UCHIC/CIWS-Loggers/Current_Designs/README.md

This folder contains the design files for the dataloggers currently in use. Each of the folders pertains to a particular datalogger, and contains the hardware and firmware/software design files, along with relevant documentation.
