UCHIC/CIWS-Loggers/Current_Designs/Residential_Datalogger/Tools/README.md

This folder contains software tools to aid in setup and operation of the Residential Datalogger.<br/>
The folder RawDataCollector contains a program that the Residential Datalogger can use to store raw data from the magnetometer. This is useful for anyone needing to characterize the magnetic signal coming from a register.<br/>
The folder RawDataProcessor contains a python module that takes the raw data and processes it to verify if certain settings will work.
