UCHIC/CIWS-Loggers/Current_Designs/Campus_Datalogger/Software/README.md

There are two scripts here for two different dataloggers:

meterlog.py: For the datalogger equipped to measure one water line

Integratable_multimeter_logger_with_temperature_and_chunkingTest.py: For the datalogger equipped to measure three water lines and temperature
