UCHIC/CIWS-Loggers/doc/requiredcomponents.md

### Required components to build the AggieWater Smart Water Meter
1 - Raspberry Pi 3 - Model B - ARMv8 with 1G RAM with Raspbian operating system in a 8GB SD card  
1 - USB WiFi (802.11b/g/n) Module with Antenna for Raspberry Pi  
1 - MCP3008 - 8-Channel 10-Bit ADC With SPI Interface  
1 - Perma-Proto HAT for Pi  with GPIO header  
1 - AH3761 High sensitivity hall effect lacth  
1 - Mini DC/DC Step-Down (Buck) Converter - 5V @ 1A output - TSR12450   
7 - 10k resistors  
2 - 1k resistors  
1 - red led  
1 - green led  
1 - 12 pin header  
4 - header jumpers  
4 - pair of screw in terminal blocks  
1 - Deep cycle Battery with at least 10AH 12v  
1 - Pelycan box with capacity to hold the datalogger and battery  

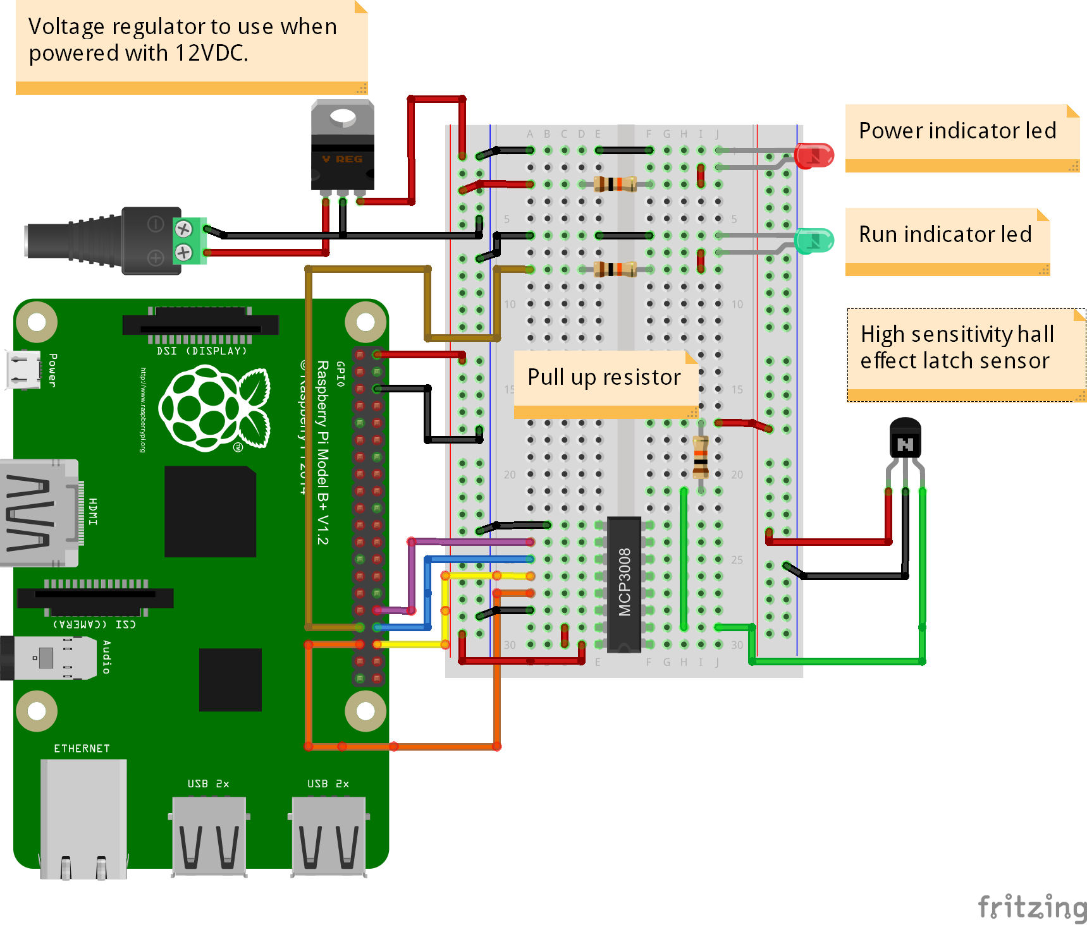
[picture p2: doc/images/MCP3008__to_RPI.png]

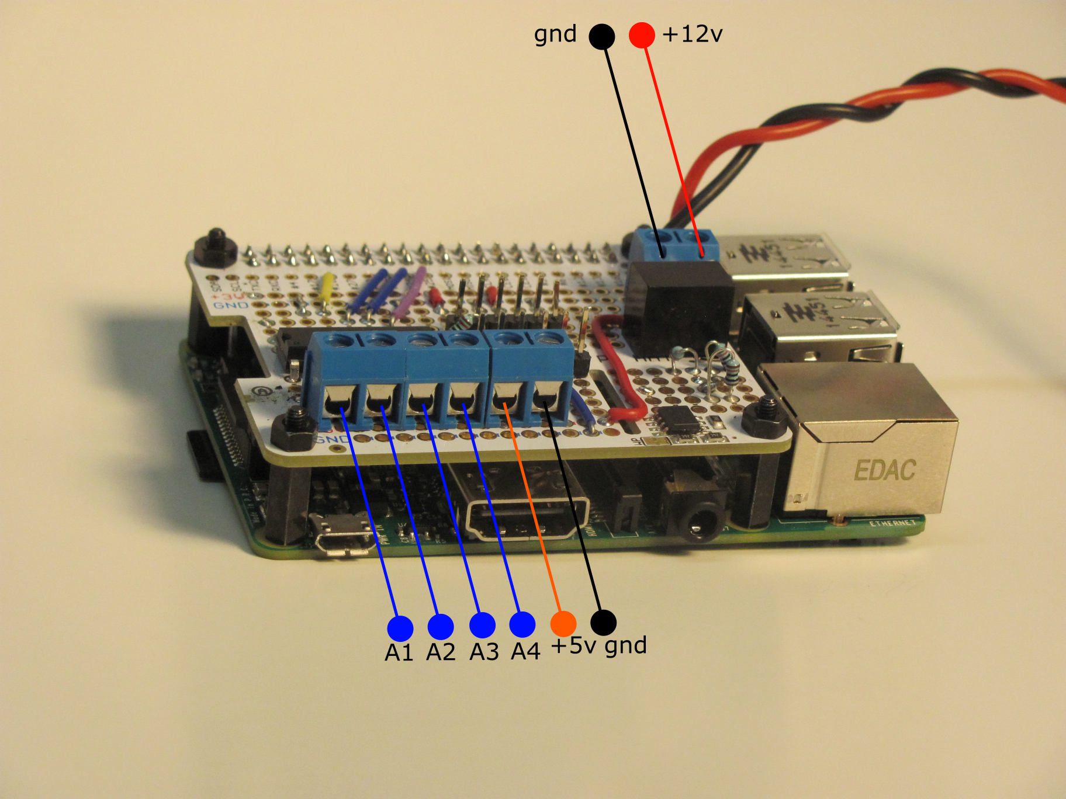
[picture p3: doc/images/AGGIEWATER_PORTS.png]
