UCHIC/CIWS-Loggers/Current_Designs/Residential_Datalogger/Hardware/README.md

This folder contains documents relating to hardware design and construction. The circuits seen in Residential_Design.pdf are added to the prototyping area of the Adafruit Datalogging Shield (Product #1141). Modifications to the shield are detailed in Datalogger_Shield_Modification_Instructions.txt. The layout is demonstrated in Residential_Layout.png, and the final product is shown in Residential_Datalogger.jpg.
