UCHIC/CIWS-Loggers/Current_Designs/Residential_Datalogger/Tools/RawDataProcessor/X_Data.csv

Raw_signal | Signal_with_offset_removed | Schmitt_trigger_output | Pulses_counted
-10.000000 | -10.000000 | 0.000000 | 0.000000
-10.000000 | -9.500000 | 0.000000 | 0.000000
-10.000000 | -9.025000 | 0.000000 | 0.000000
-10.000000 | -8.573750 | 0.000000 | 0.000000
-10.000000 | -8.145061 | 0.000000 | 0.000000
-10.000000 | -7.737808 | 0.000000 | 0.000000
-10.000000 | -7.350918 | 0.000000 | 0.000000
-10.000000 | -6.983372 | 0.000000 | 0.000000
-10.000000 | -6.634203 | 0.000000 | 0.000000
-10.000000 | -6.302492 | 0.000000 | 0.000000
-10.000000 | -5.987368 | 0.000000 | 0.000000
-10.000000 | -5.688000 | 0.000000 | 0.000000
-10.000000 | -5.403600 | 0.000000 | 0.000000
-10.000000 | -5.133419 | 0.000000 | 0.000000
-10.000000 | -4.876748 | 0.000000 | 0.000000
-10.000000 | -4.632911 | 0.000000 | 0.000000
-10.000000 | -4.401265 | 0.000000 | 0.000000
-10.000000 | -4.181202 | 0.000000 | 0.000000
-10.000000 | -3.972141 | 0.000000 | 0.000000
-10.000000 | -3.773534 | 0.000000 | 0.000000
-10.000000 | -3.584857 | 0.000000 | 0.000000
-10.000000 | -3.405614 | 0.000000 | 0.000000
-10.000000 | -3.235333 | 0.000000 | 0.000000
-10.000000 | -3.073566 | 0.000000 | 0.000000
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
