UCHIC/CIWS-Loggers/Current_Designs/Residential_Datalogger/Tools/RawDataProcessor/RAW_DATA.CSV

X_Axis | Y_Axis | Z_Axis
-10 | 18 | -2
-10 | 18 | -2
-10 | 18 | -2
-10 | 18 | -2
-10 | 18 | -2
-10 | 18 | -2
-10 | 18 | -2
-10 | 18 | -2
-10 | 18 | -2
-10 | 18 | -2
-10 | 18 | -2
-10 | 18 | -2
-10 | 18 | -2
-10 | 18 | -2
-10 | 18 | -2
-10 | 18 | -2
-10 | 18 | -2
-10 | 18 | -2
-10 | 18 | -2
-10 | 18 | -2
-10 | 18 | -2
-10 | 18 | -2
-10 | 18 | -2
-10 | 18 | -2
-10 | 18 | -2
-10 | 18 | -2
-10 | 18 | -2
-10 | 18 | -2
-10 | 18 | -2
-10 | 18 | -2
-10 | 18 | -2
-10 | 18 | -2
-10 | 18 | -2
-10 | 18 | -2
-10 | 18 | -2
-10 | 18 | -2
-10 | 18 | -2
-10 | 18 | -2
-10 | 18 | -2
-10 | 18 | -2
-10 | 18 | -2
-10 | 18 | -2
-10 | 18 | -2
-10 | 18 | -2
-10 | 18 | -2
-10 | 18 | -2
-10 | 18 | -2
-10 | 18 | -1
-10 | 18 | -2
-10 | 18 | -2
-10 | 18 | -2
-10 | 18 | -2
-10 | 18 | -2
-10 | 18 | -2
-10 | 18 | -2
-10 | 18 | -2
-10 | 18 | -2
-10 | 18 | -2
-10 | 18 | -2
-10 | 18 | -1
-10 | 18 | -2
-10 | 18 | -2
-10 | 18 | -2
-10 | 18 | -2
-10 | 18 | -2
-10 | 18 | -2
-10 | 18 | -2
-10 | 18 | -2
-10 | 18 | -2
-10 | 18 | -2
-10 | 18 | -2
-10 | 18 | -2
-10 | 18 | -2
-10 | 18 | -2
-10 | 18 | -2
-10 | 18 | -2
-10 | 18 | -2
-10 | 18 | -1
-10 | 18 | -1
-10 | 18 | -2
-10 | 18 | -2
-10 | 18 | -2
-10 | 18 | -2
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
