UCHIC/CIWS-Loggers/Previous_Designs/README.md

This folder contains the design files for previous versions of the datalogger prototypes. They are no longer in use, and are kept here to show the progression of the project.
