UCHIC/CIWS-Loggers/Previous_Designs/Hybrid_Prototype/README.md

This is the firmware for the original Computational Datalogger, nicknamed the "Hybrid Prototype" because it involved two main devices, an AVR Microcontroller and a Raspberry Pi.
