UCHIC/CIWS-Loggers/Current_Designs/Campus_Datalogger/Hardware/4-20mA_Pi_Hat_Design.png

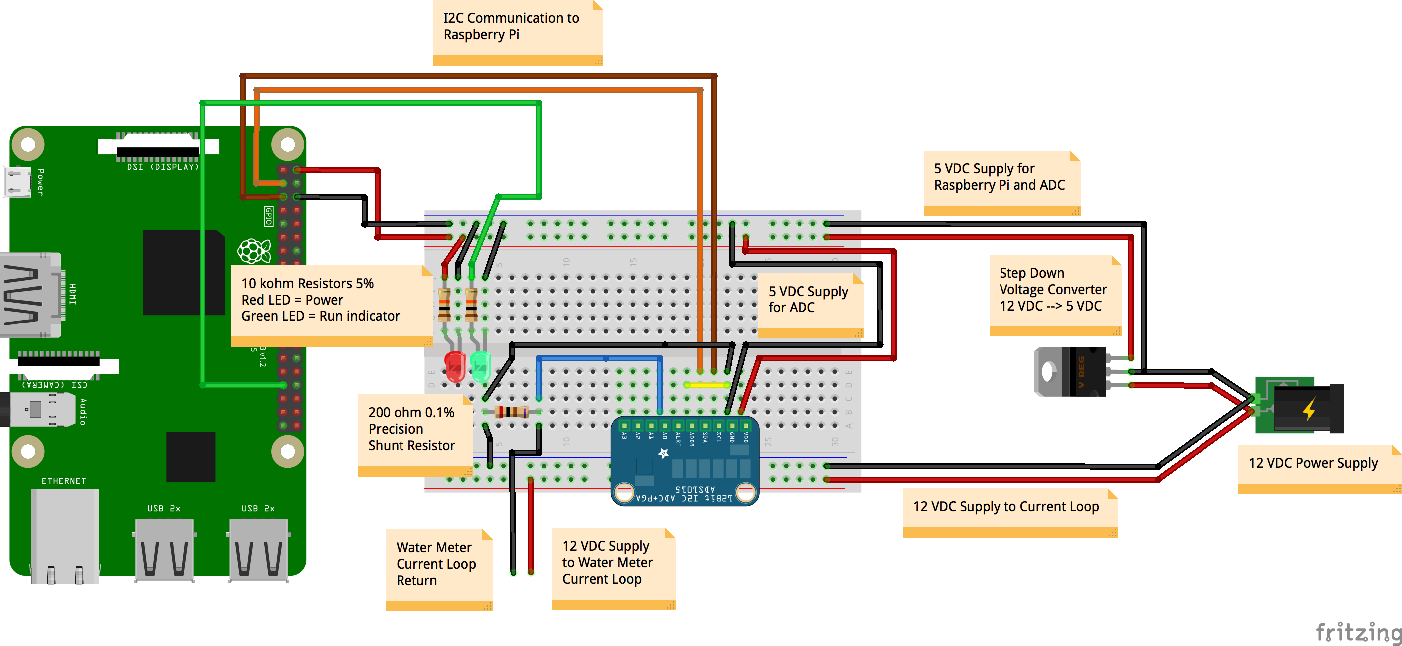
Current_Designs/Campus_Datalogger/Hardware/4-20mA_Pi_Hat_Design.png
