UCHIC/CIWS-Loggers/Current_Designs/Campus_Datalogger/Hardware/IntegrateableCampusResidential_WithADC.jpg

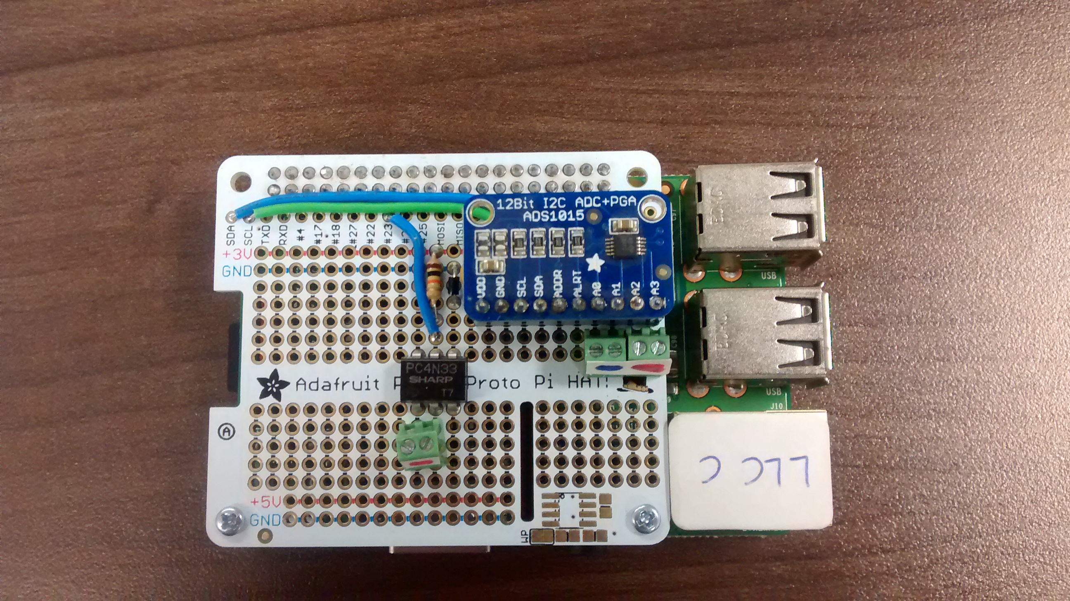
Current_Designs/Campus_Datalogger/Hardware/IntegrateableCampusResidential_WithADC.jpg
