UCHIC/CIWS-Loggers/Current_Designs/Campus_Datalogger/Hardware/IntegrateableCampusResidential_WithoutADC.jpg

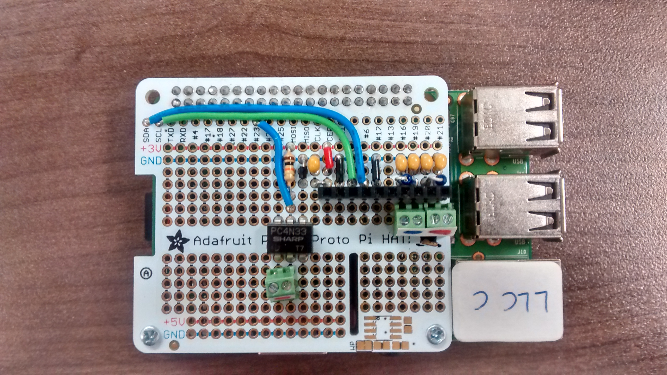
Current_Designs/Campus_Datalogger/Hardware/IntegrateableCampusResidential_WithoutADC.jpg
