UCHIC/CIWS-Loggers/Current_Designs/Campus_Datalogger/Hardware/Proto_4-20_hat.jpg

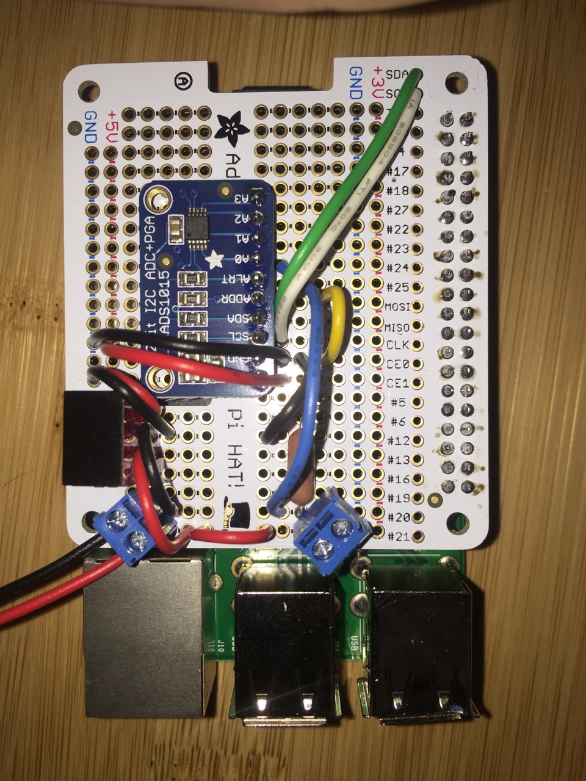
Current_Designs/Campus_Datalogger/Hardware/Proto_4-20_hat.jpg
