UCHIC/CIWS-Loggers/Current_Designs/Residential_Datalogger/Hardware/Residential_Datalogger.jpg

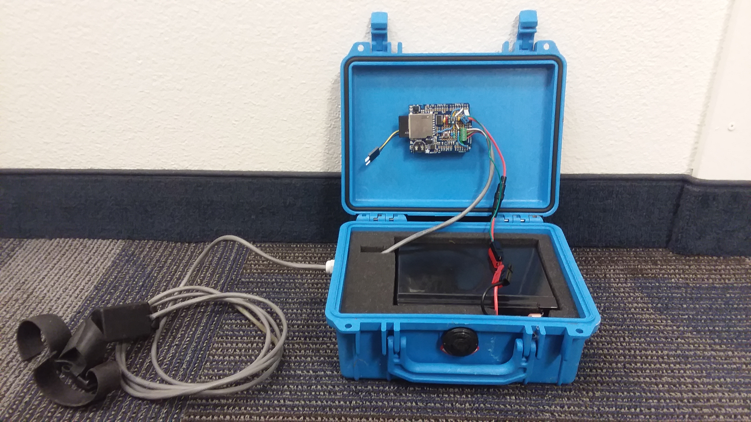
Current_Designs/Residential_Datalogger/Hardware/Residential_Datalogger.jpg
