UCHIC/CIWS-Loggers/Current_Designs/Residential_Datalogger/Hardware/Residential_Layout.png

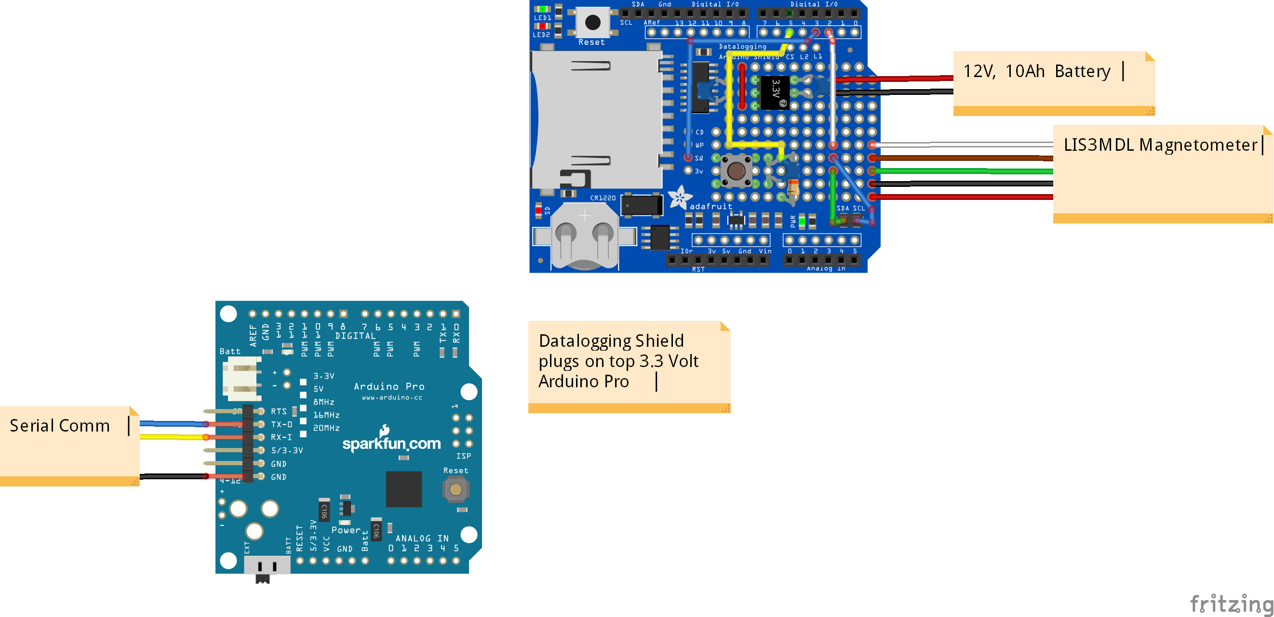
Current_Designs/Residential_Datalogger/Hardware/Residential_Layout.png
