UCHIC/CIWS-Loggers/doc/images/AGGIEWATER_ADC_PI_HAT.png

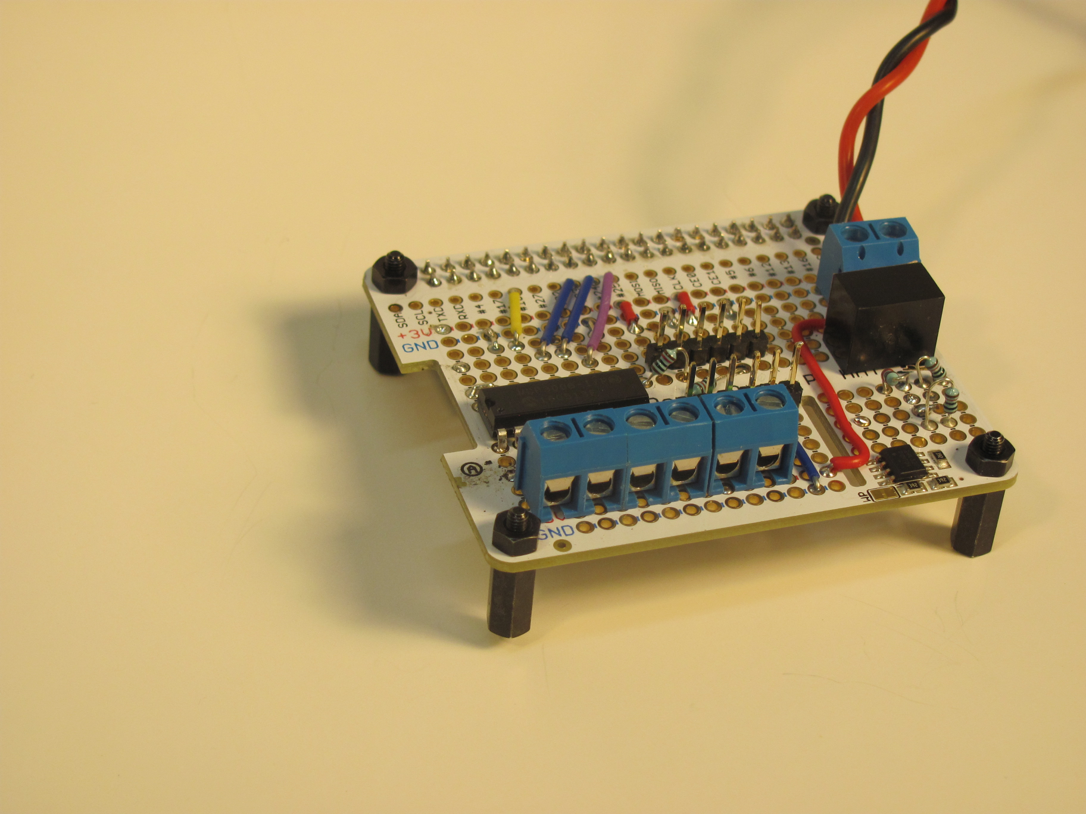
doc/images/AGGIEWATER_ADC_PI_HAT.png
