UCHIC/CIWS-Loggers/doc/images/AGGIEWATER_CLOSED_CASE.png

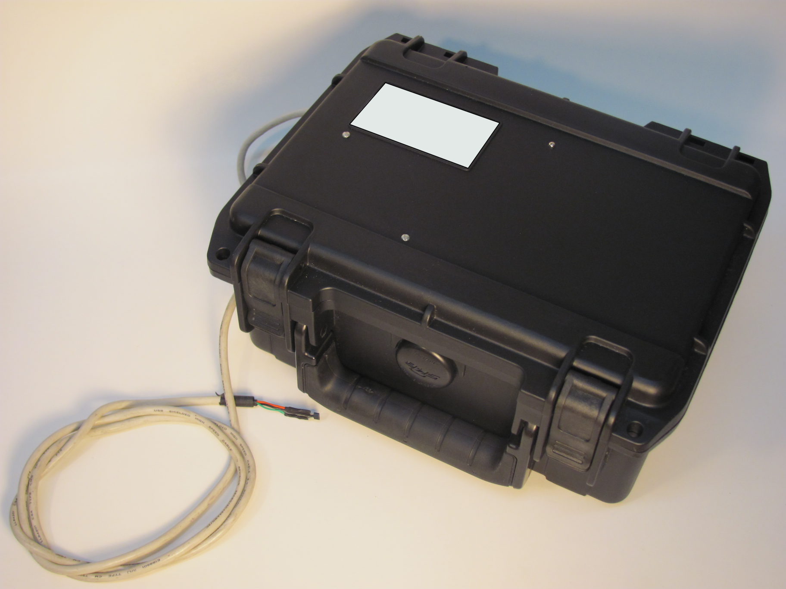
doc/images/AGGIEWATER_CLOSED_CASE.png
