UCHIC/CIWS-Loggers/doc/images/AGGIEWATER_SYSTEM_CLOSEUP2.png

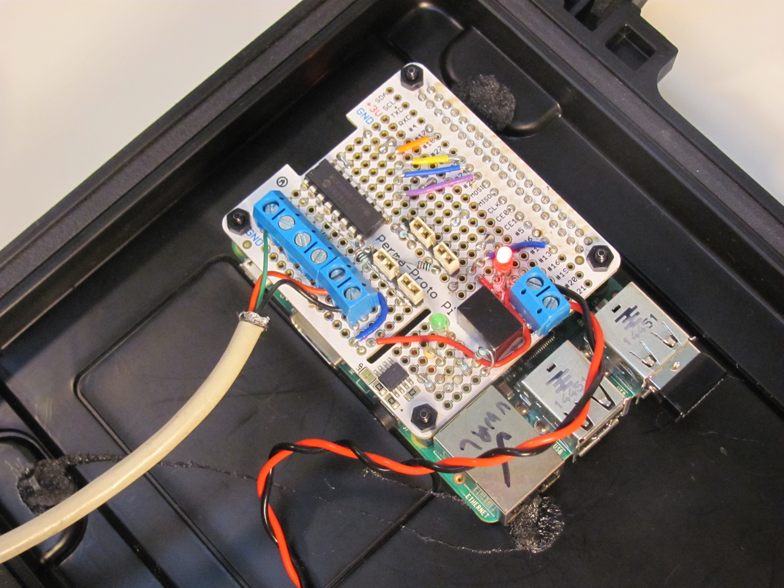
doc/images/AGGIEWATER_SYSTEM_CLOSEUP2.png
