UCHIC/CIWS-Loggers/doc/images/AGGIEWATER_SYSTEM_CLOSEUP.png

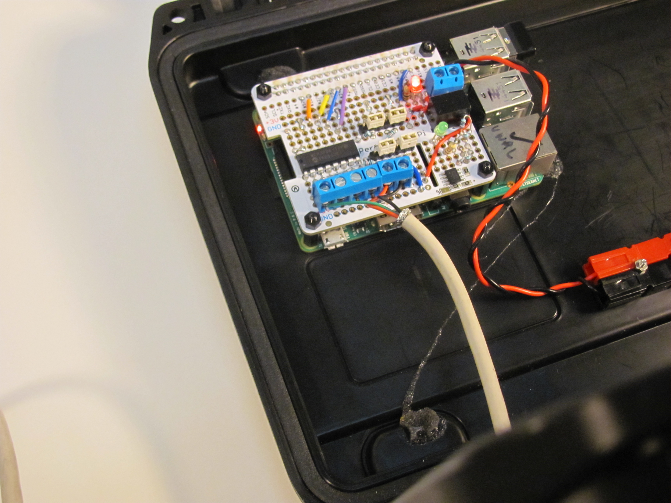
doc/images/AGGIEWATER_SYSTEM_CLOSEUP.png
