UCHIC/CIWS-Loggers/doc/images/WaterMeter.png

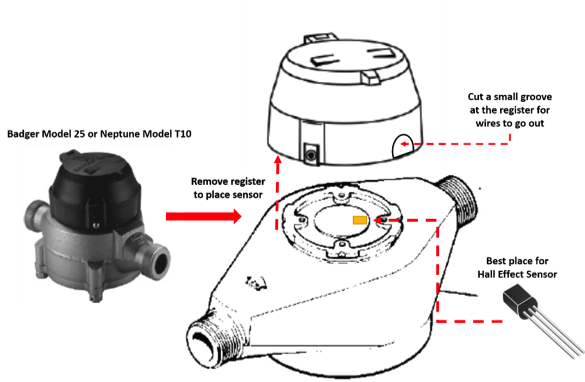
doc/images/WaterMeter.png
