UCHIC/CIWS-Loggers/hardwaredesign/Arduino_SD_Design_bb.png

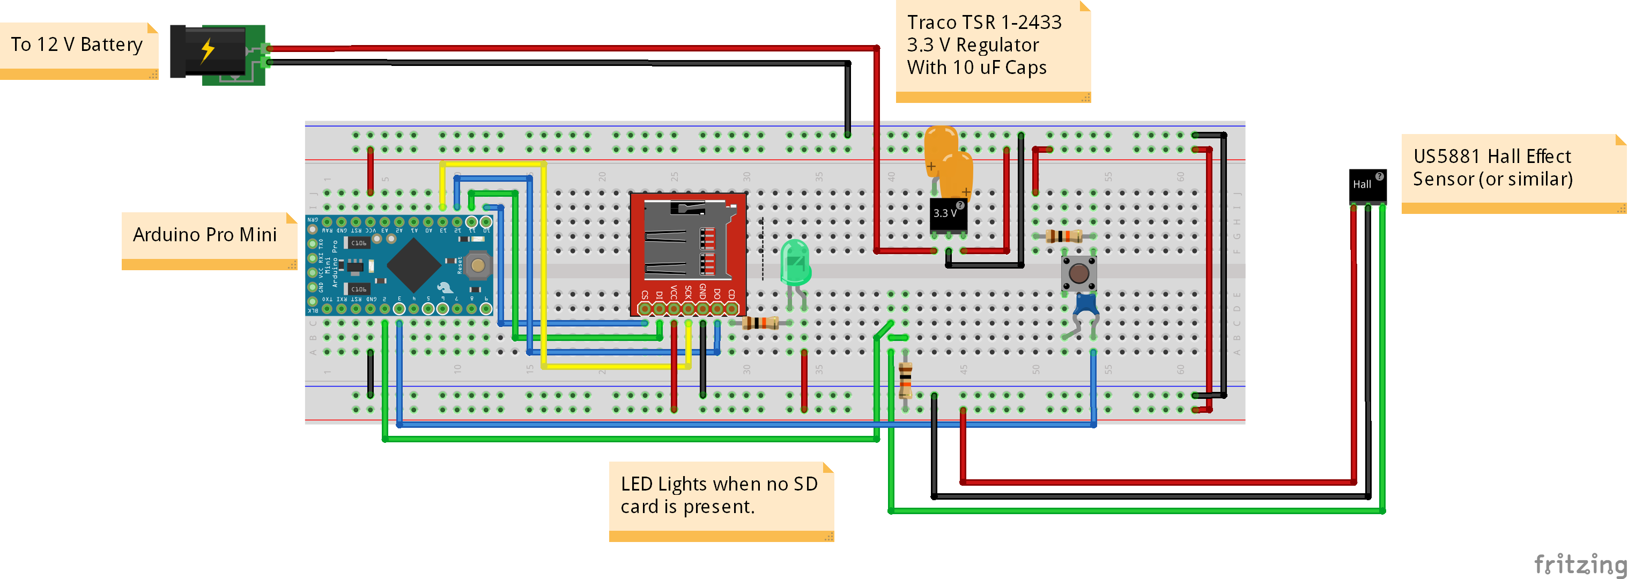
hardwaredesign/Arduino_SD_Design_bb.png
