UCHIC/CIWS-Loggers/hardwaredesign/BattMeas.png

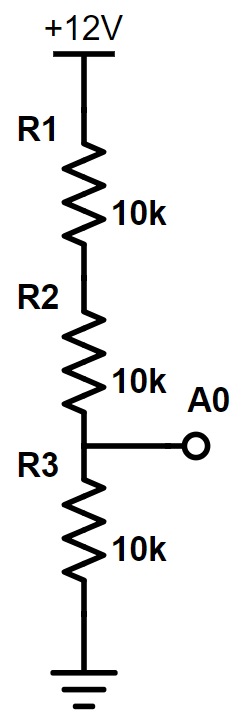
hardwaredesign/BattMeas.png
