UCHIC/CIWS-Loggers/hardwaredesign/HybridPrototype/Power_Control_Signal_Timing_ATtiny.png

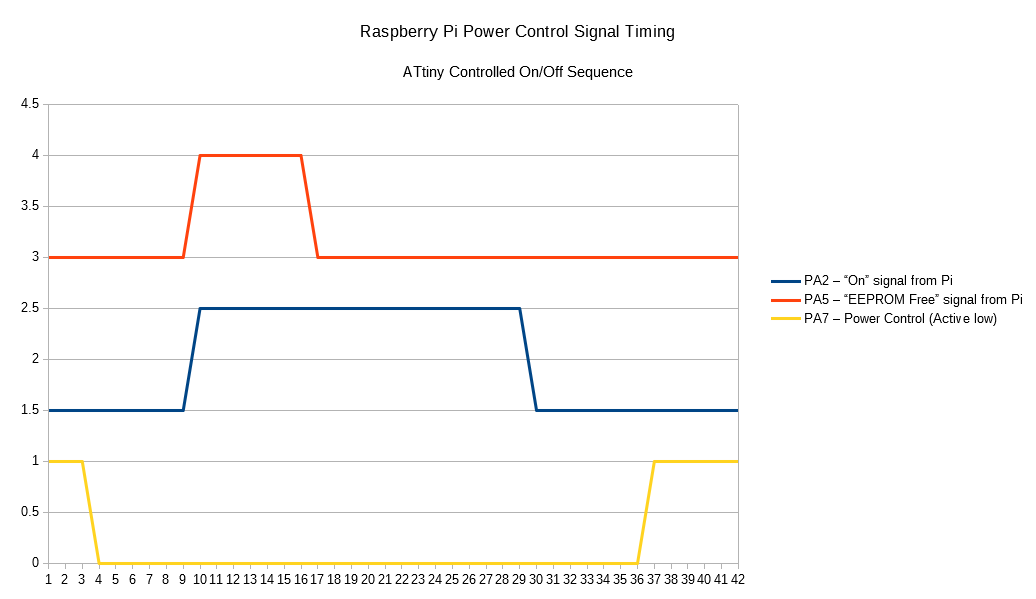
hardwaredesign/HybridPrototype/Power_Control_Signal_Timing_ATtiny.png
