UCHIC/CIWS-Loggers/hardwaredesign/HybridPrototype/Residential_Prototype_Data_Sample_Formating.png

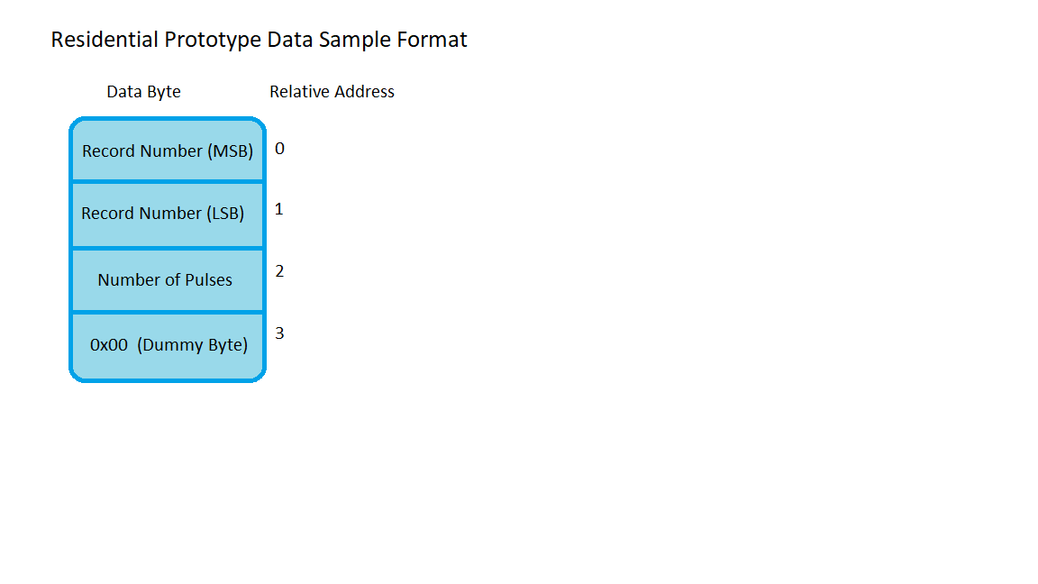
hardwaredesign/HybridPrototype/Residential_Prototype_Data_Sample_Formating.png
