UCHIC/CIWS-Loggers/doc/gettingstarted.md

## Configuring and deploying the system
The following images show how we are configuring and deploying the residential piggy-back smart metering devices.



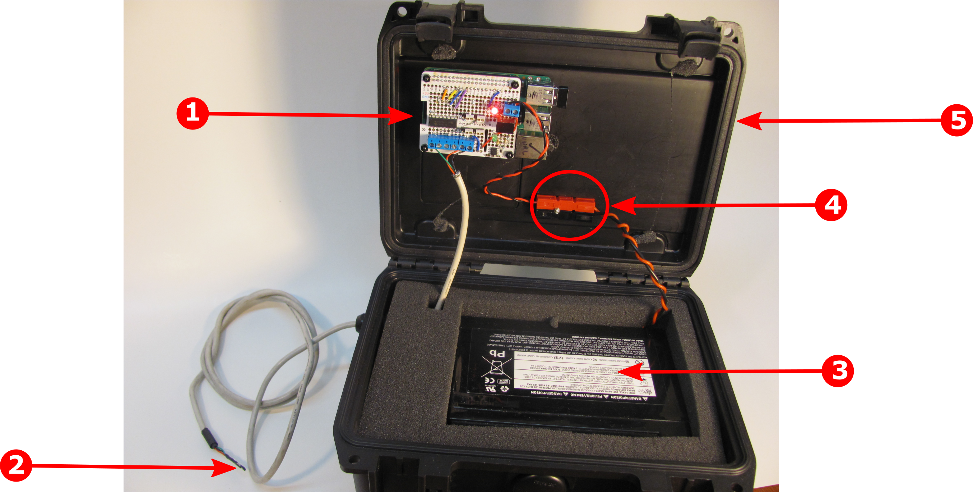
[picture p20: doc/images/AGGIEWATER_PACK.png]


1. Datalogger using Raspberry Pi and custom made Pi hat.  
2. Hall effect senser wired to the datalogger.  
3. Battery pack.  
4. Power on and off connector.  
5. Weather proof case.

## Setting up and starting the system

To start using the this system just plug in the power on/off connector and wait 20 seconds for the system to boot. Make sure your battery is fully charge to extract the most of the data collection run. Once the system is up, plug an ethernet cable between the Raspberry and a laptop computer and follow the intructions below.

### Change laptop computer network adapter ip address

Right-click on the network adapter you want to assign an IP address and click Properties. Highlight Internet Protocol Version 4 (TCP/IPv4) then click the Properties button. Now change the IP, Subnet mask, Default Gateway, and DNS Server Addresses. When you're finished click OK. This setting is only  needed once if the same laptop computer is used to communicate to the AggieWater system.

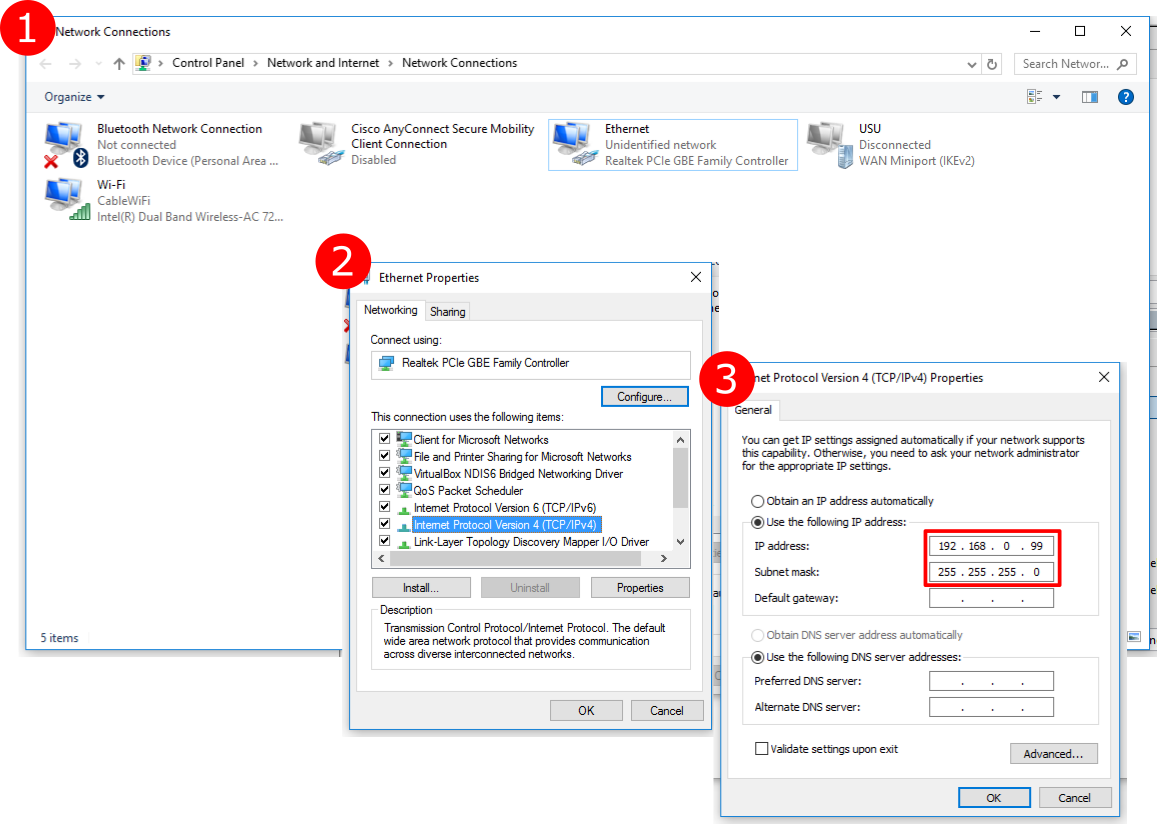
[picture p21: doc/images/static_ip.png]


### SSH into the Raspberry Pi
We have assigned an unique static IP address to all the prototypes we have created that can be found in a label on the lid of the weather proof case. The label also contains user and password information to access the Raspberry Pi.

#### Windows
Use Putty or any other terminal emulator.  

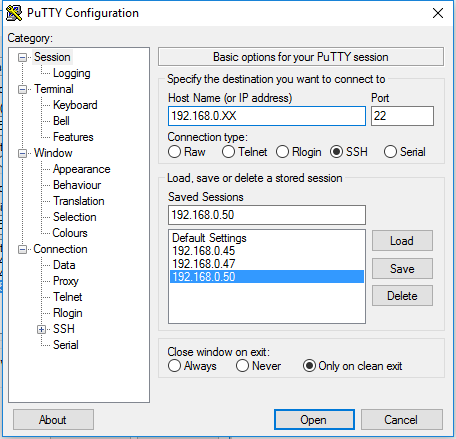
[picture p22: doc/images/putty.png]


#### Mac and linux
Use the system default terminal type the following and hit enter:  

   <pre>
   ssh pi@192.168.0.XX
   </pre>

When prompted for credentials type the password provided and hit enter.  Once a connection is stablished, all the following settings will happen in the Raspberry Pi.

### Set system date
The system do not have a backpup power supply to hold the date when power cycled. Use the following command to set the date when the system is powered:

<pre>
date -s "2 OCT 2006 18:00:00"
</pre>

### Set conf.xml file
We have created an .xml file that contains the basic set up information for the system to start the datalogging routine. This file can be used to add the required METADATA for the identification of the site and variables.
```
<data>
    <items>
        <item name="Datalogger:" value = "Raspberry pi"></item>
        <item name="Sitename:" value = "Site name goes here."></item>
        <item name="Port1:" value = "adc1" initial_value = "11500"></item>
        <item name="Port2:" value = "adc2" initial_value = "11500"></item>
        <item name="Port3:" value = "adc3" initial_value = "11500"></item>
        <item name="Port4:" value = "adc4" initial_value = "11500"></item>
                <item name="Site_description" value= "Brief site description goes here"></item>
                <item name="Time_support" value= "4"></item>
                <item name="Data_directory" value="/home/pi/Datalog/"></item>
    </items>
</data>
```
Use the following instructions to modify the conf.xml file.  

Type on the terminal:
```
nano conf.xml
```
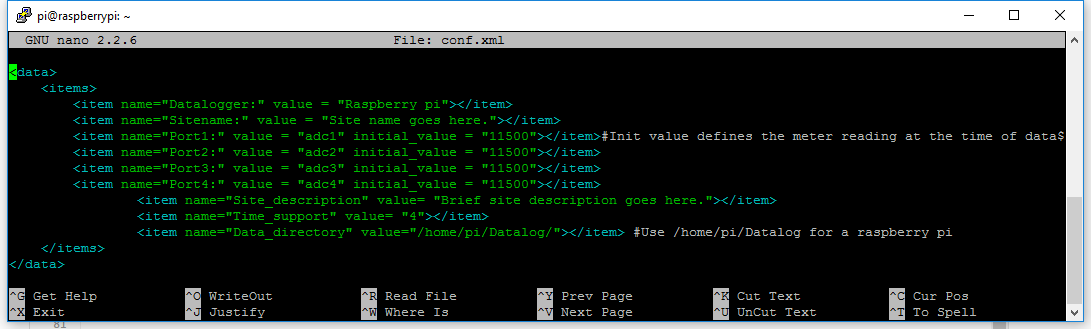
[picture p23: doc/images/conf.png]


Modify conf.xml accordignly. When finished use the hotkey (<kbd>CTRL</kbd>+<kbd>X</kbd>), hit (<kbd>Y</kbd>) to accept modifications, verify filename and hit (<kbd>ENTER</kbd>) to save the file.

We are now ready to start logging data.

## Run sensor_module.py

This is the main script that will be running while collecting data. Use the following command to start the sensor_module.py script:
```
cd WaterMonitor/src/
sudo python sensor_module.py &
```

## Stop sensor_module.py

```
sudo killall python
```

## Using the listener.py

We can visualize the real time data stream from the sensor by just running the script listener.py. This script prints to screen any message generated by the sensor. In order to run this script just type the following command in the terminal after accessing the raspberry pi over ssh:

```
cd WaterMonitor/src/
sudo python listener.py
```
In order to stop the listener just use the hotkey (<kbd>CTRL</kbd>+<kbd>C</kbd>).

## Calibration

In order to obtain accurates flow readings the sensor needs to be calibrated by determining the conversion factor to use when converting from water meter rotation to volume of water. We will be adding some calibration files in this section.

## Data retrieval

A new data file is created everytime the sensor_module.py script is initialized, if the sensor_module.py script is not re-initialized the data is appended to the same file created during last initialization of the script.  

You can download for free the software FileZilla from here https://filezilla-project.org/download.php?type=client.  

Use FileZilla's site manager to enter the credentials of your AggieWater system, this prevent from having to enter the same information all over everytime data is collected. 

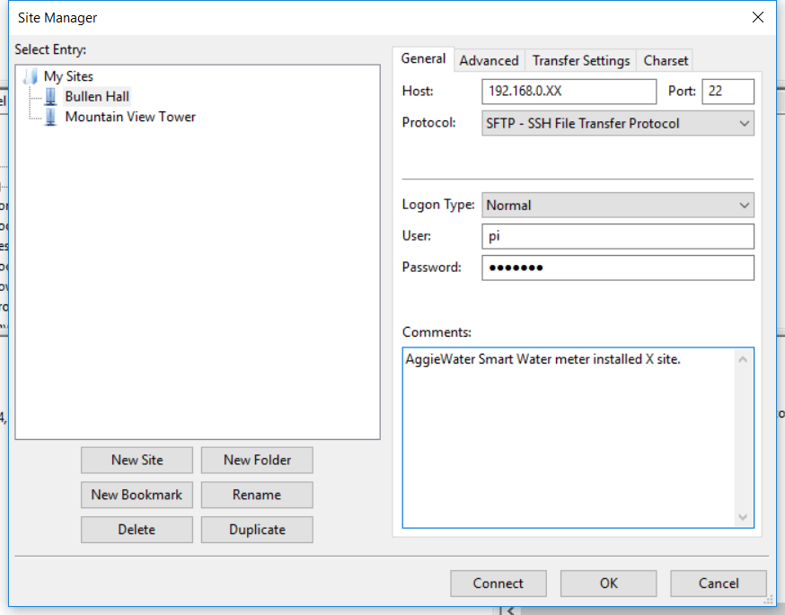
[picture p24: doc/images/filezilla_site.png]


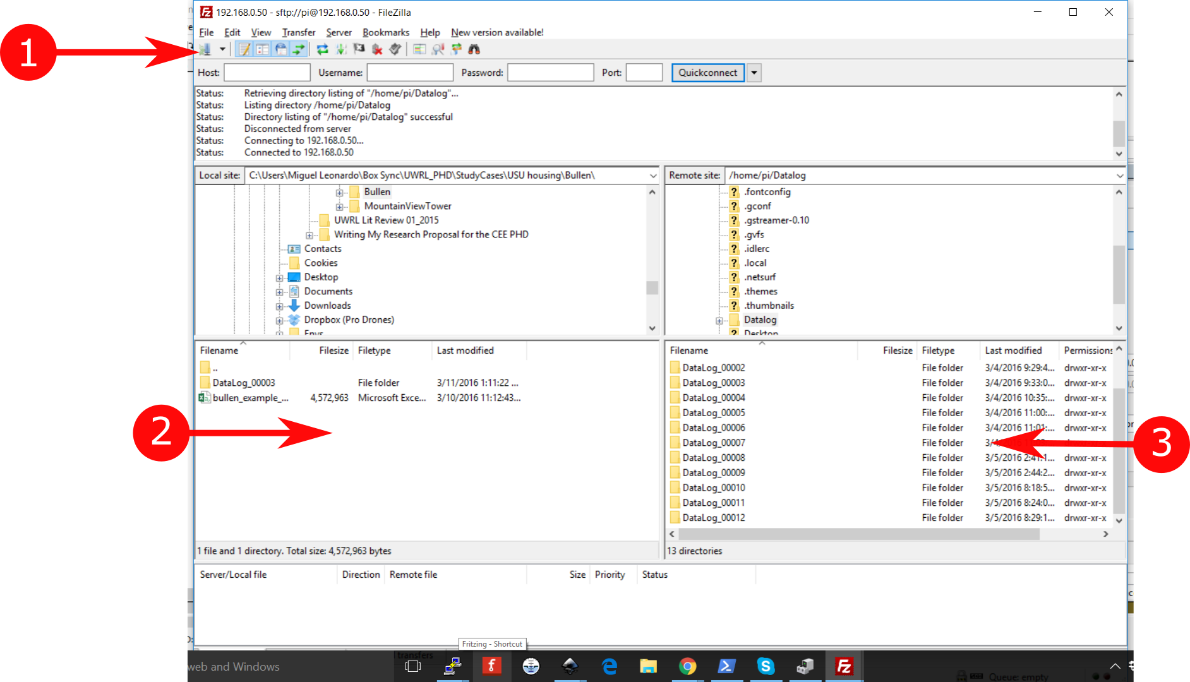
[picture p25: doc/images/filezilla_data.png]


In order to connect to the site and collect the data:  
1. Find your site and hit connect.  
2. Find the location on your local computer where to store the data.  
3. Find the data on the raspberry /home/pi/Datalog directory and drag the file to your local directory.   

Data is now retrieved you can disconnect from the AggieWater system and enjoy proccessing.
