UCHIC/CIWS-Loggers/hardwaredesign/HybridPrototype/Power_Control_Signal_Timing_Manual.png

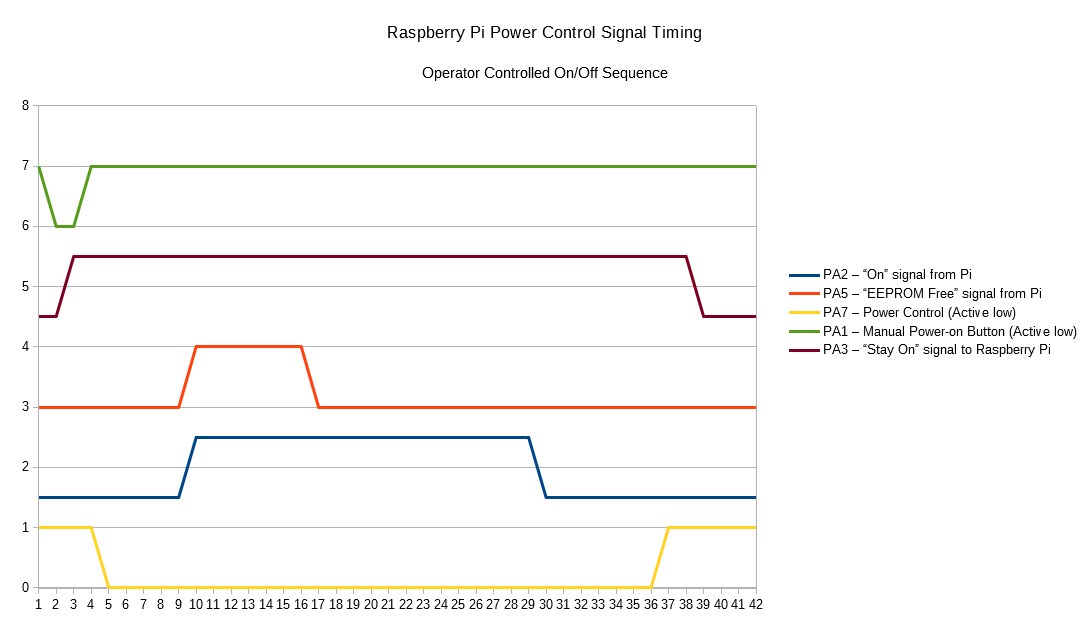
hardwaredesign/HybridPrototype/Power_Control_Signal_Timing_Manual.png
