UCHIC/CIWS-Loggers/(threads)

Thread 1 (2016-09-09):

4-20mA de-noising circuit

karunmj, 2016-09-09:

tracy2995, 2019-03-11:
Signal noise significantly lessened by differential measuring on the ADC with filtering capacitors. See most recent hardware schematic.

tracy2995, 2019-07-26:
Circuit de-noised.

Closed 2019-07-26.
