UCHIC/CIWS-Loggers/Current_Designs/Residential_Datalogger/Hardware/Residential_Design.pdf

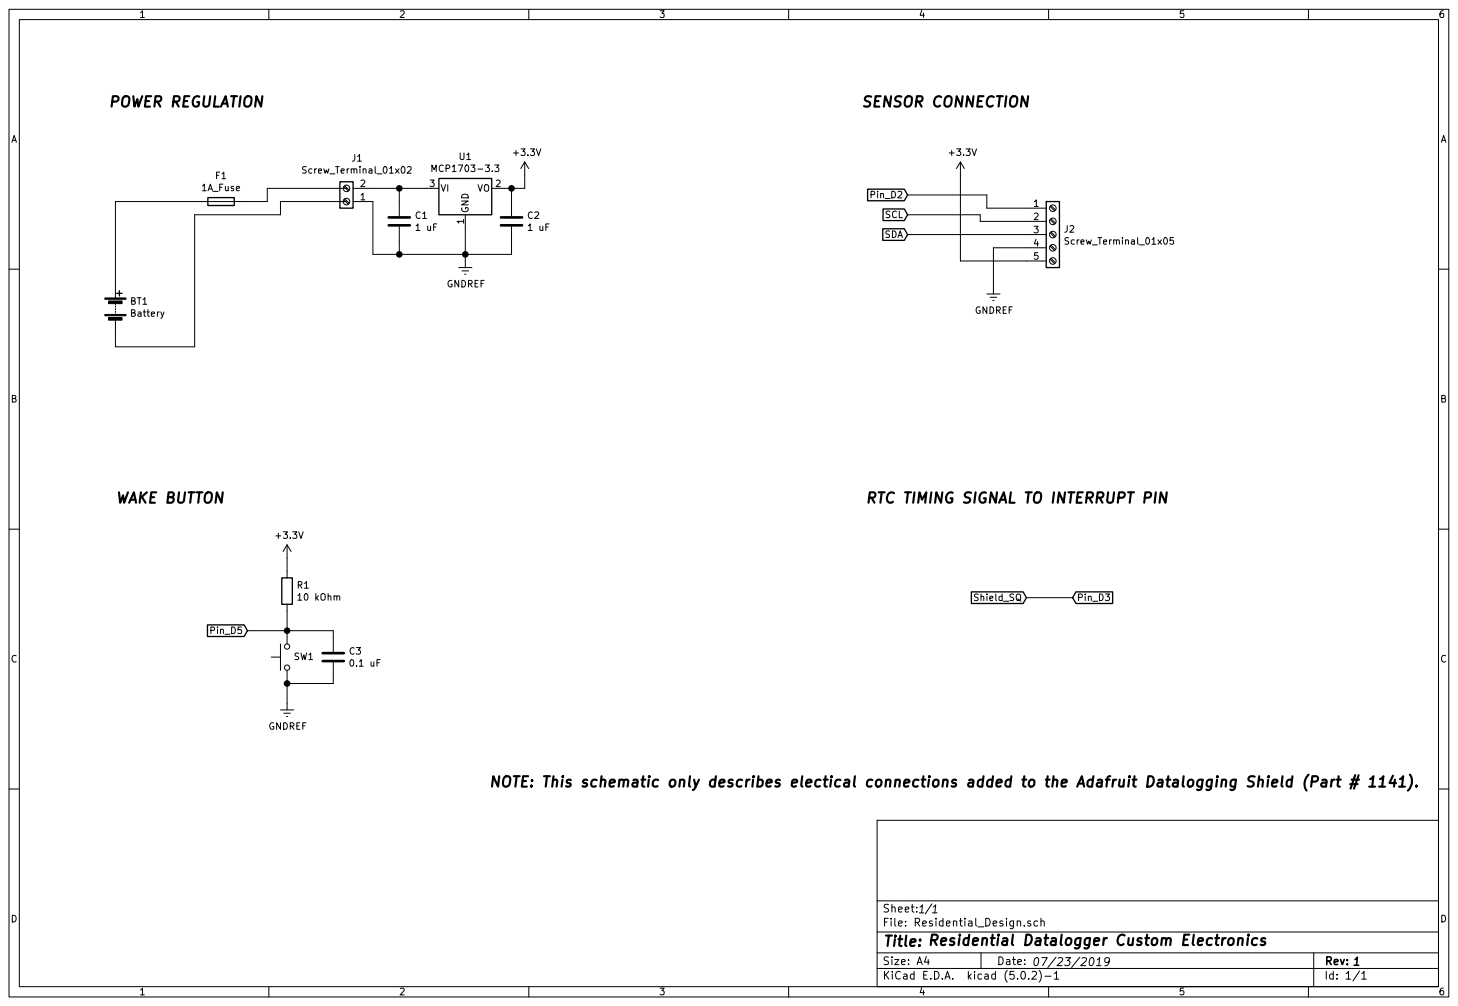
[picture p27: page 1]

Residential Datalogger Custom Electronics
