UCHIC/CIWS-Loggers/Current_Designs/Campus_Datalogger/Hardware/Campus_Residential_Schematic_v2.pdf

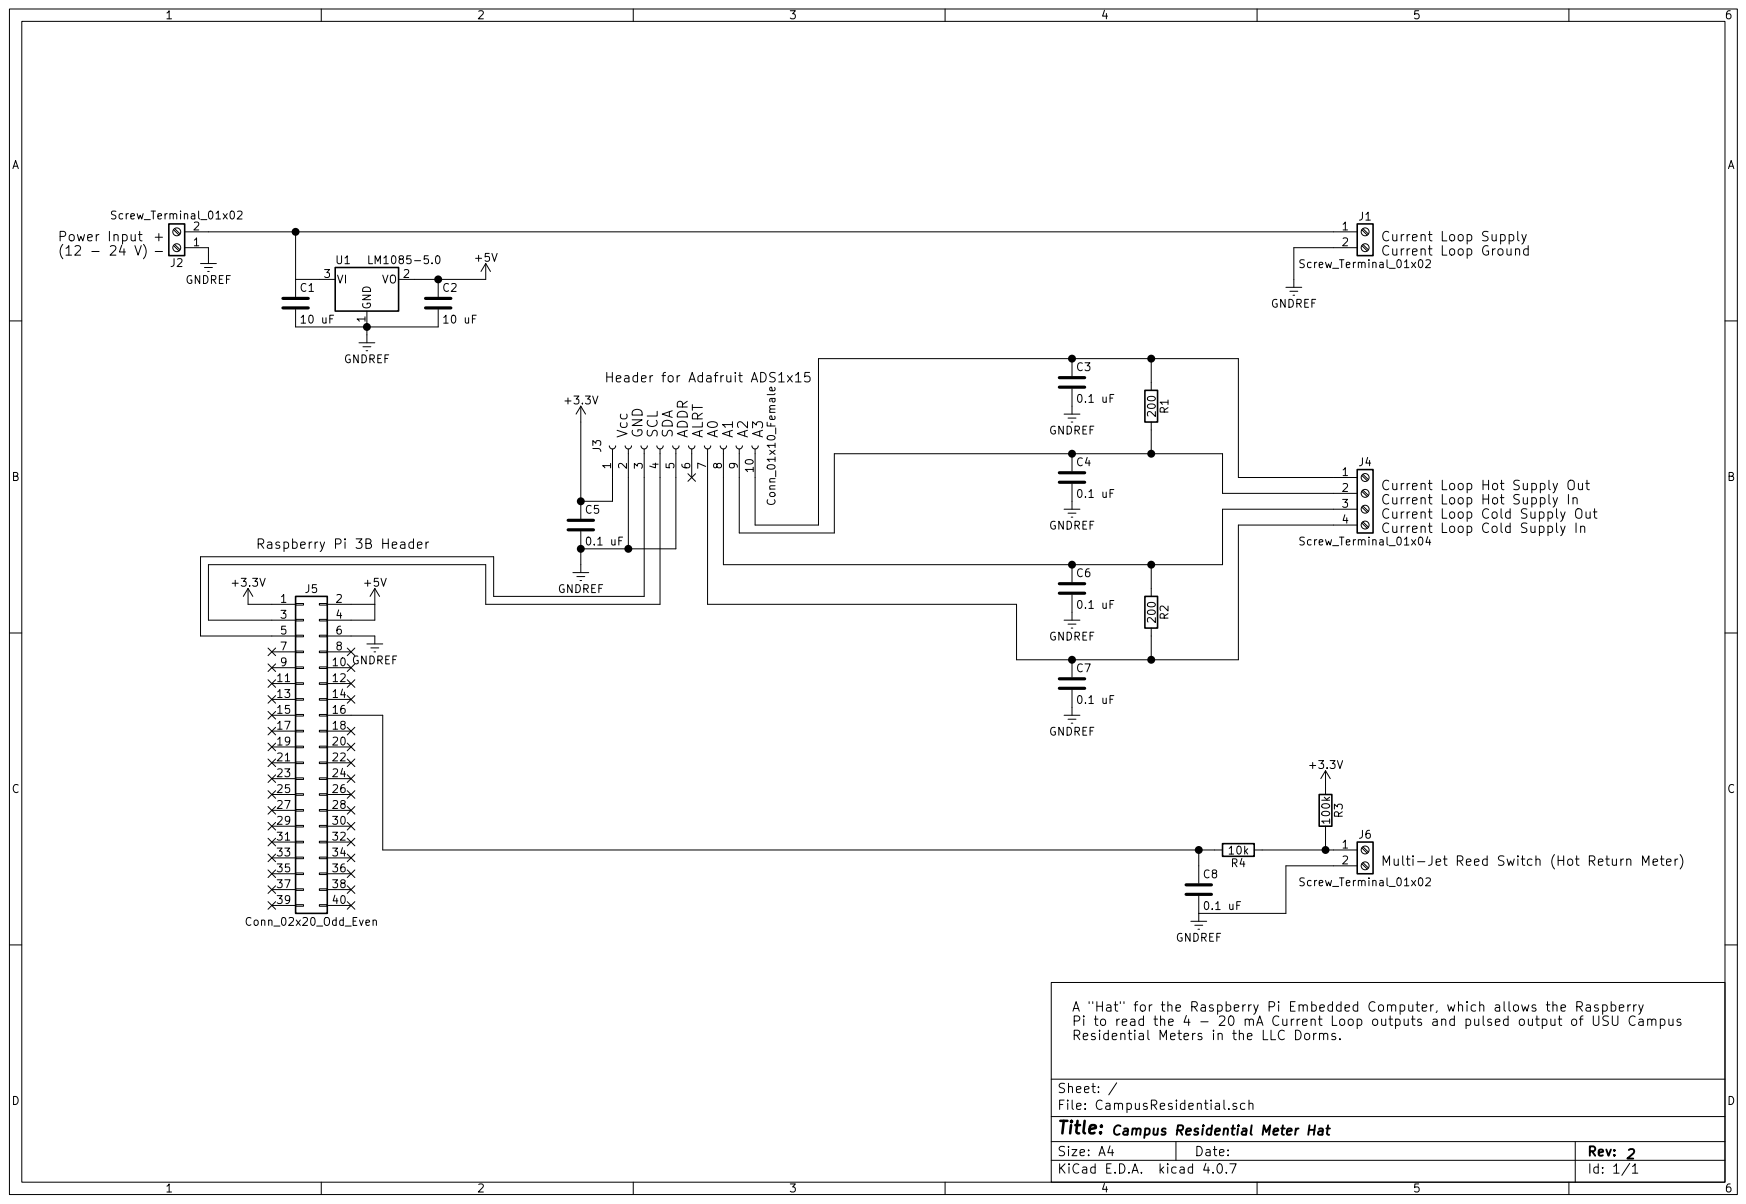
[picture p28: page 1]
