UCHIC/CIWS-Loggers/Current_Designs/Campus_Datalogger/Hardware/IntegrateableCampusResidential_v1.pdf

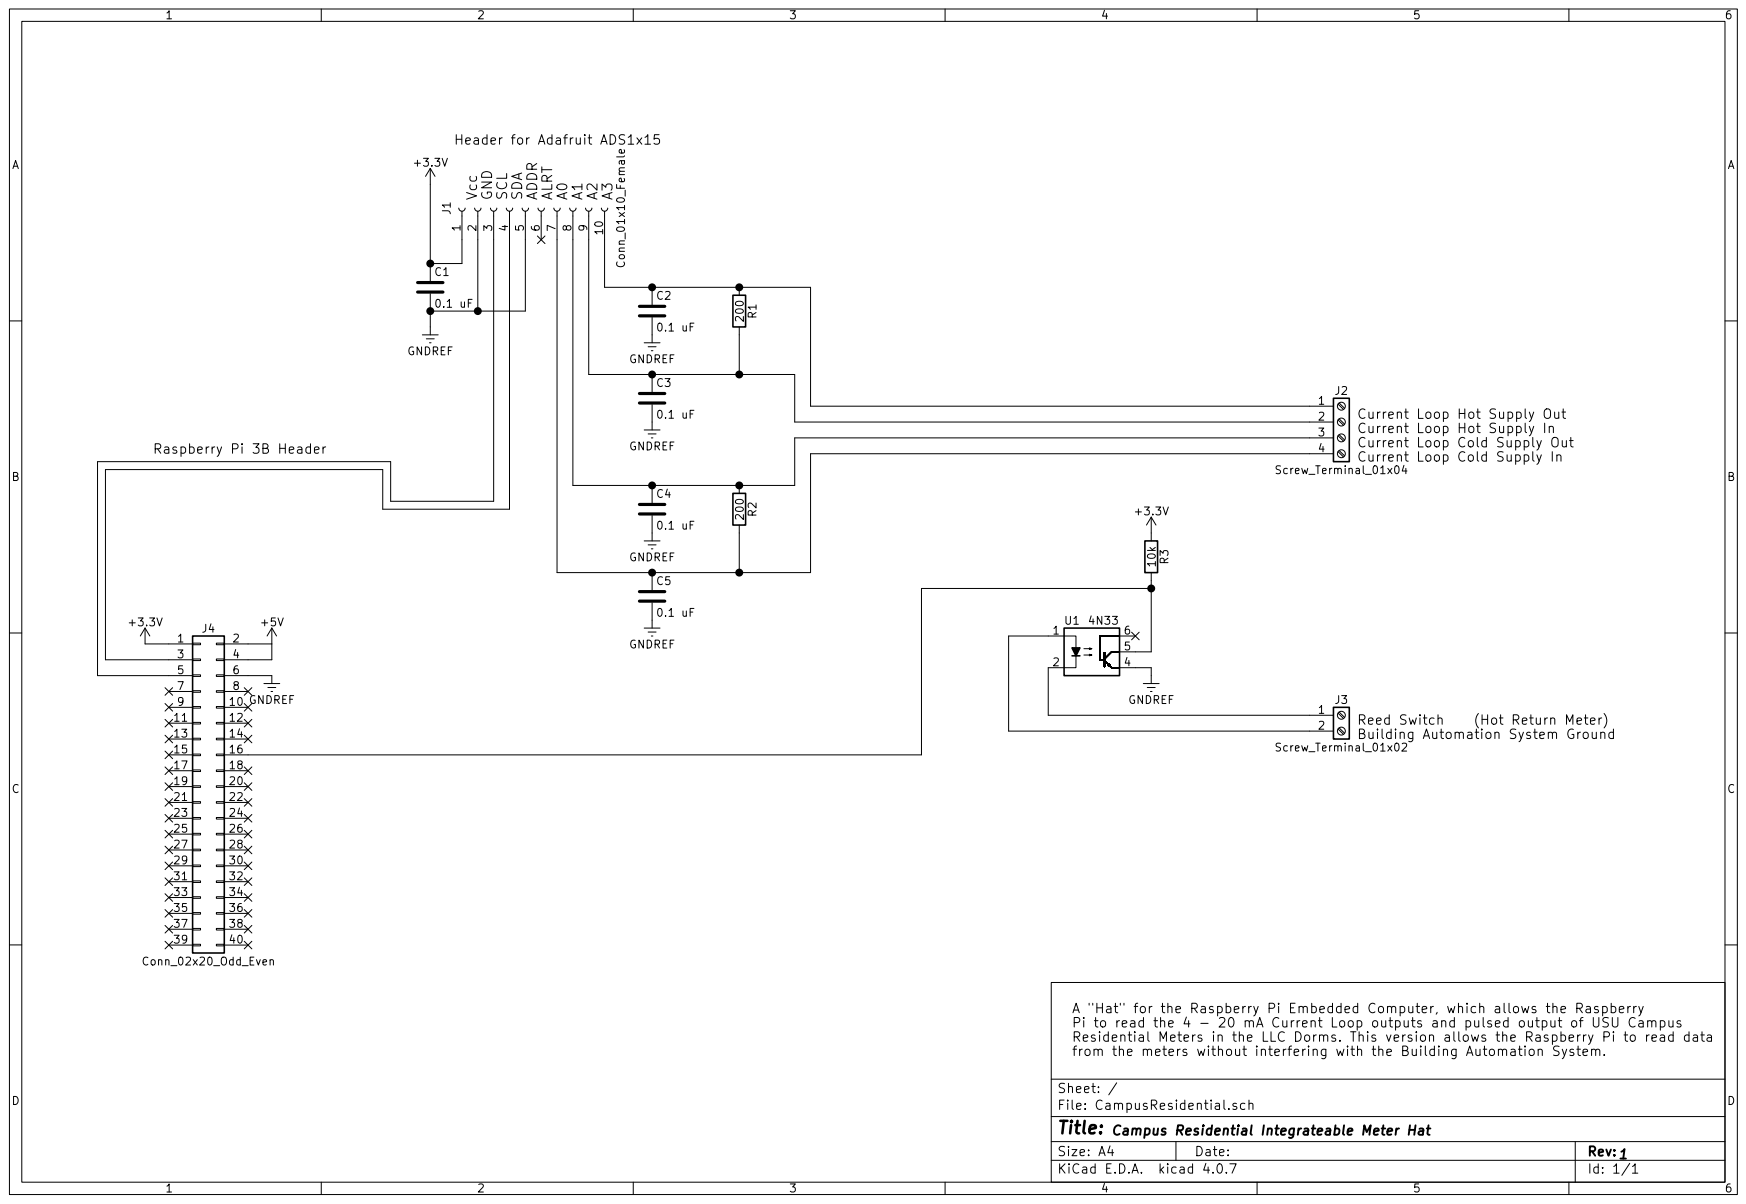
[picture p29: page 1]
