UCHIC/CIWS-Loggers/Current_Designs/Campus_Datalogger/Hardware/Campus_Residential_Schematic_Rev_1.pdf

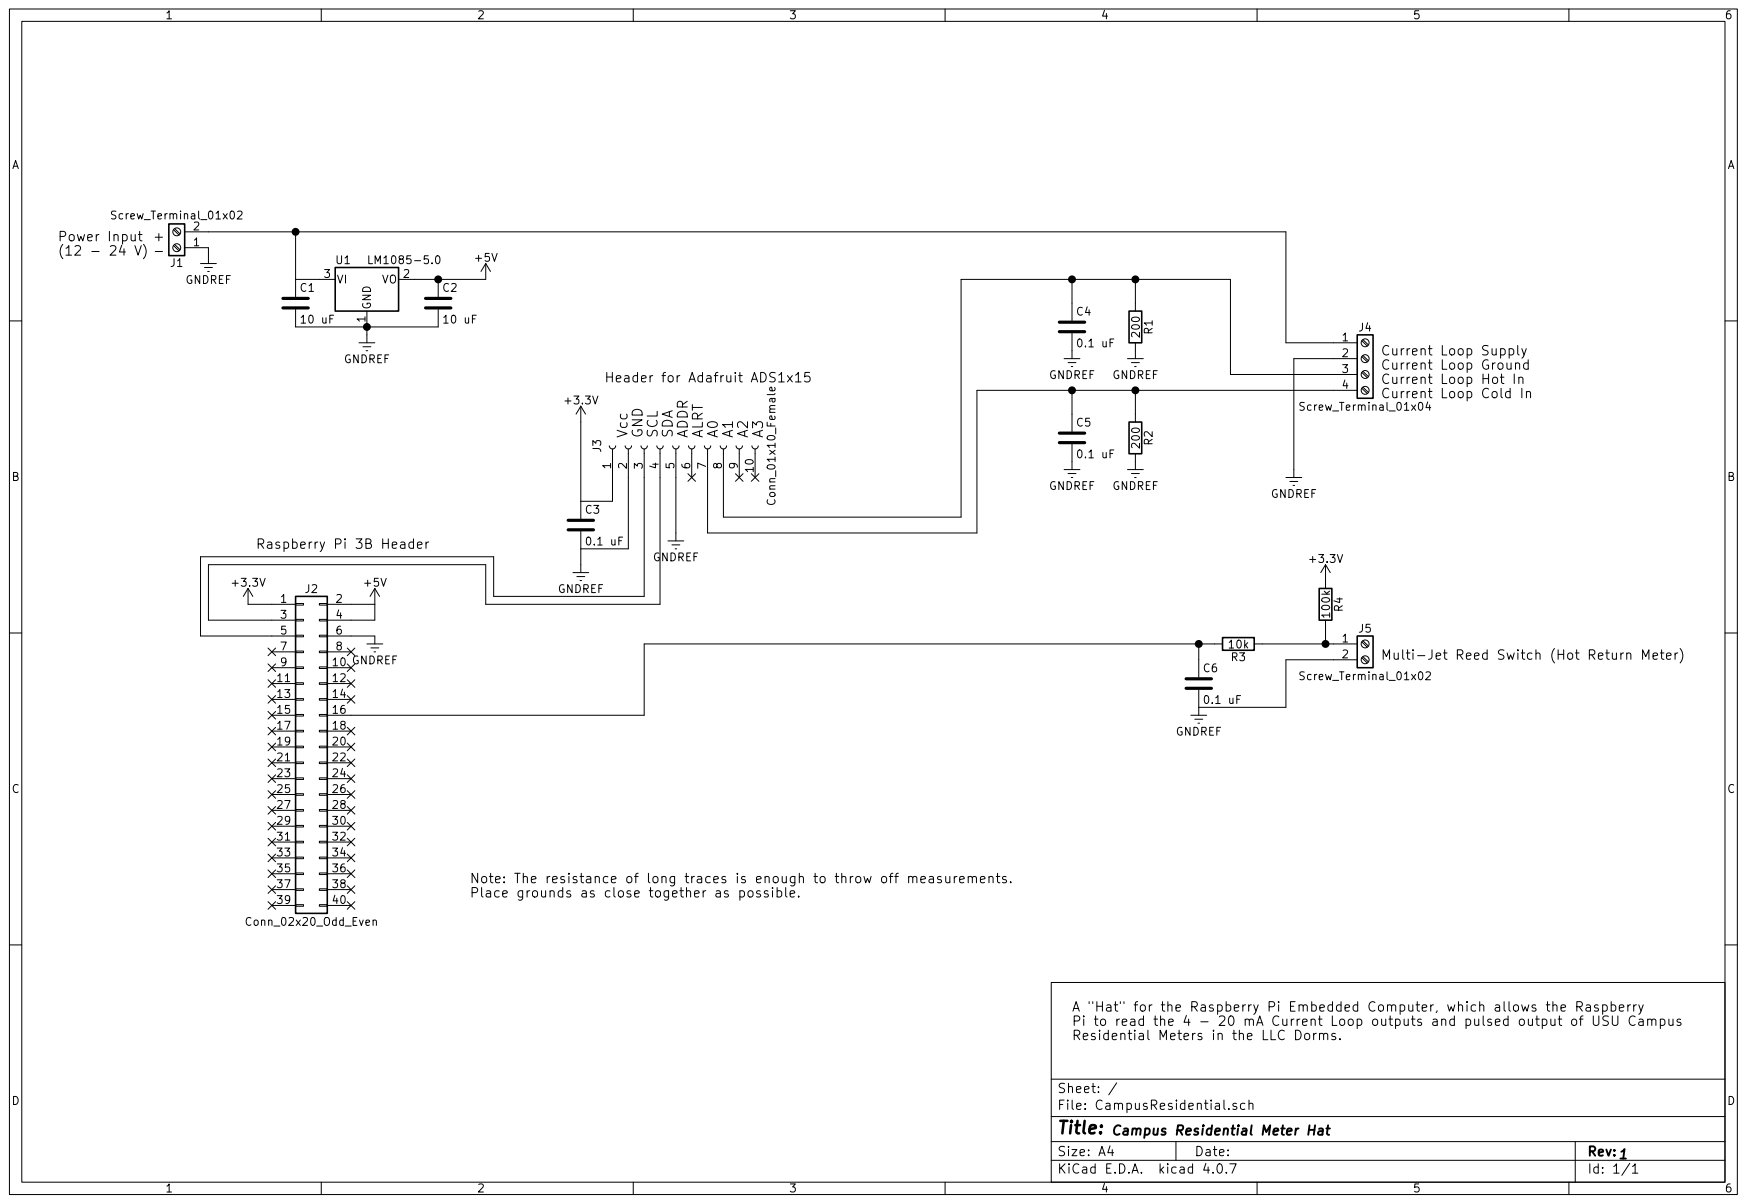
[picture p30: page 1]
