UCHIC/CIWS-Loggers/(list of files, drawings)

Other design files:
Current_Designs/Campus_Datalogger/Hardware/4-20mA_Pi_Hat_Design.fzz
hardwaredesign/Arduino_SD_Design.fzz
Previous_Designs/Residential_Prototype/Hardware/Arduino_SD_Design.fzz
