UCHIC/CIWS-Loggers/(commit log)

2014-03-27 Added new sensor configuration files
2014-04-07 Added Adafruit Driver
2014-08-15 Modified sensor_module
2014-08-18 Cleaned sensor_module.py
2014-08-20 Updated sensor module
2014-08-20 Modified sensor module
2015-02-12 Modified send_email.py to print ip address of the host.
2015-02-18 Added system monitor to sensor module
2015-02-18 Fixed bug on sensor_module.py
    [sensor_module.py]
2015-02-19 Fixed bug on sensor_module.py about conversion from string to integer on the configuration file.
    [sensor_module.py]
2015-02-19 Updated sensor_module.py
2016-04-12 Create udplistener
    Run this code in separate terminal from the one the main smart water meter code is running to listen to the messages from the sensor.
2016-04-13 Basic circuit diagram
2016-04-19 Removed parts list
    It’s in the readme file already
2016-06-01 Removed adc settings
2016-08-31 Adding hardware design
    [4-20mA_Pi_Hat_Design.fzz]
2016-09-12 Adding photo of prototype 4-20 hat
2017-03-12 Adding sensor placement image
2017-05-06 Set-up remote host in Pycharm
    Connecting remotely to Richards Hall Logger using Pycharm. Also update
    .gitignore for new .xml files
    [(500ms)datalog_Richards_Hall_2017-4-29_9-57-18.csv]
2017-05-16 Fixed timestamp to accommodate milliseconds
    Okay, I think this will work, I still need to run tests on the pi and
    finalize.
    [subSecondMeterLog.py]
2017-05-31 Removing .csv file
    [(500ms)datalog_Richards_Hall_2017-4-29_9-57-18.csv]
2017-06-09 Correcting some bugs in the code
    Had a bug with the save location and a few others.
    [subSecondMeterLog.py]
2017-06-12 Noise calculation file
    Created a file used to only output sensor values. Not complete yet.
2018-03-30 Adding modified version of piggy-back logging code
    Rewrote Miguel’s original data logging code to make it simpler and
    easier to understand.
2018-05-08 Add files via upload
    Schematic of hardware used on the Residential Prototype to monitor battery life, not included in other diagrams.
2018-05-16 Add files via upload
    Code for a new Campus Residential Prototype, integrating both current loop output meters and the pulsed output meter.
    (Slightly Modified from Dr. Horsburgh's original code to allow usage of the ADS1115 ADC)
2018-05-16 Add files via upload
    Hardware schematic of the Campus Residential Prototype (measurement for all three meters integrated).
2018-05-16 Add files via upload
    Schematic of the Campus Residential Prototype, to be used on buildings with water supply meters with 4mA - 20mA current loop outputs and a water return meter with pulsed output.
2018-05-18 Add files via upload
    A design for a residential meter logger which hopefully uses less power. Notes/Comments on the design will be added soon.
2018-05-18 Add files via upload
    Low-Power Residential Meter Logger design with notes and comments.
2018-05-22 Add files via upload
    Another variant of the Residential Piggy-back water meter logger. This one utilizes serial EEPROM chips instead of an SD card for data storage, as EEPROM chips draw less current.
2018-06-02 Add files via upload
    Updated Residential Prototype design with pull-up resistors added on I2C lines. Code to be posted soon.
2018-07-02 Create Fuses
2018-07-12 Add files via upload
    Test Script for the Campus Residential Meters.
    - Measures all 3 meters
    - Known issues:
    > ADC voltage not converted properly
    > Flow rate not converted properly
    [multimeter_logger_test.py]
2018-07-18 Add files via upload
    This script fixes a few voltage bugs and properly reads a reed switch.
    [multimeter_logger_test_2.py]
2018-07-19 Add files via upload
    Current design for the Campus Residential Prototype
2018-07-26 Add files via upload
    Code for a slightly different version of the Hybrid Prototype, eliminating the ADC for battery voltage measurements and using the pin to control an I2C buffer between the RPi and the rest of the system
2018-08-06 Update main.c
    Changed the variable recordMax to do a short-term test of the Prototype's automatic functions.
    [main.c]
2018-08-16 Create FUSES
    File describing the "fuse" settings for the ATtiny84 microcontroller.
2018-08-17 Add files via upload
    Schematic for the Campus Residential Logger Hat. This version allows the logger to be interfaced to the meters while the Building Automation System is also interfaced to the meters.
2018-08-17 Add files via upload
    Photos of the finished Integratable Campus Residential prototypes
2018-08-17 Add files via upload
    Campus Residential Schematic for new version which should measure more accurately
2018-08-21 Delete Residential_Prototype_Schematic_Rev_6.pdf
    Deleting old files. New schematic coming soon.
2018-08-21 Delete Residential_Prototype_Schematic_Rev_7.pdf
    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
2018-09-19 Add files via upload
    In-progress Schematic for SD card datalogging microcontroller prototype.
    [SD card ATmega328 prototype.sch]
2018-09-20 Add files via upload
    Revision A.1 adds Hall effect sensor and custom symbol for the micro SD card breakout
    [SD card ATmega328 prototype.sch]
2018-10-09 Add files via upload
    Fritzing file for SD Prototype Hardware design
    [Arduino_SD_Design.fzz]
2018-10-09 Add files via upload
    Arduino sketch for SD Datalogger Prototype
2018-10-09 Add files via upload
    Hardware design for SD Prototype
2018-10-13 Add files via upload
    Test code: PCF8523 RTC for Arduino
2018-10-27 Create Datalogger_Shield_Modification.txt
    Steps to modify datalogger shield to work with a low-power Arduino configuration.
2018-12-08 Update Firmware.ino
    Fixed a time-formatting bug
    Colon came after ten's place 0 in seconds. Moved to line 284 instead of line 288.
    [Firmware.ino]
2018-12-11 Delete integrateable_multimeter_logger_with_temperature.py
    Small Errors. Will replace with fresh script.
    [integrateable_multimeter_logger_with_temperature.py]
2019-01-28 Update magnetometer.cpp
    Updated comments
2019-01-28 Update magnetometer.h
    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
2019-01-29 Update magnetometer.cpp
    Added lines 54 to 59 for testing/debugging purposes.
2019-01-29 Update magnetometer.cpp
    Updated the test/debugging code. Graphs waveform and detected peaks, to help debug the peak counting algorithm.
2019-01-29 Update magnetometer.cpp
    Fixed mistaken edits
    [magnetometer.cpp]
2019-01-30 Update integrateable_multimeter_logger_with_temperature.py
    Fixed bug: script spawns hundreds of threads and crashes. Yikes.
    Created a flag so that the threads are not started until they have ended.
    [integrateable_multimeter_logger_with_temperature.py]
2019-01-30 Update detectPeaks.cpp
    Fixed the debugging code. Now should see a datalog.csv output and a waveform.csv output.
    waveform.csv has both the waveform as well as where peaks are detected.
    [detectPeaks.cpp]
2019-01-30 Update Firmware.ino
    Fixed issue: datalogger didn't log pulses correctly because of a syntax error on line 205:
    if(peak); to if(peak)
    [Firmware.ino]
2019-02-06 Update magnetometer.cpp
    Changed sampling rate to 80 Hz. Verified with oscilloscope.
2019-02-06 Update powerSleep.cpp
    Set sleep mode to Standby: a full power-down took too long to wake back up, which cut the sample rate.
    Changed startup delay time for TWI interface from 10 ms to 1 us.
    [powerSleep.cpp]
2019-02-06 Update magnetometer.cpp
    Bug fix: datalogger has to recalibrate every time it logs
    Fix: checks SignalState->firstRun. If it is not the first run, then calibration data is not reset. Flag is added in state.h.
    [magnetometer.cpp]
2019-02-06 Update state.h
    Added firstRun flag to SignalState to fix recalibration bug. Program will check firstRun to decide if calibration data needs initialization.
    [state.h]
2019-03-06 Add files via upload
    Test Code:
    Tests a new pulse-counting algorithm from raw magnetometer data. Much more robust.
    This does not run on a microcontroller, just a PC with a C compiler should do just fine. The text files hold test data.
2019-03-08 Add files via upload
    New Magnetometer version with a better algorithm for detecting peaks.
2019-03-08 Add files via upload
    Fixed Bug in detectPeaks.cpp Algorithm now detects peaks.
    [Firmware.ino, detectPeaks.cpp]
2019-03-11 Rename hardwaredesign/HybridPrototype/Software/ATtiny84_Code/Fuses to src/HybridPrototype/Software/ATtiny84_Code/Fuses
    Moved C files to src directory (whoops... code isn't hardware)
2019-03-14 Add files via upload
    Updated signal conditioning parameters
    Added option to switch signal conditioning parameters based on meter size
2019-03-15 Add files via upload
    Fixed Serial Output Formatting Issue
    [handleSerial.cpp]
2019-03-20 Add files via upload
    Updated Code, fixed funny bugs
    [Firmware.ino, RTC_PCF8523.cpp, RTC_PCF8523.h, handleSerial.cpp, handleSerial.h, powerSleep.cpp, state.h, storeNewRecord.h]
2019-03-22 Update state.h
    Corrected a typo on line 29: 0.005 to -0.005
    [state.h]
2019-03-27 Add files via upload
    Fixed minor timestamp formatting bug (seconds leading zero came before colon)
    [Firmware.ino]
2019-04-29 Add files via upload
    Code for Magnetometer based prototype using the LIS3MDL three-axis accelerometer.
2019-05-08 Add files via upload
    Added following functionality:
    1) View water flow in real-time
    2) Read total flow from terminal
    3) Adjustable configuration data stored in ROM (site #, ID #, meter size)
    4) Configuration data stored in on-chip EEPROM
    5) Fixed overflow issue in displayed total flow (8-bit number to 32-bit number)
    [Firmware.ino, handleSerial.cpp, state.h]
2019-06-11 Add files via upload
    Firmware Update:
    Filename is now nnn_ffff.csv, n = site number, f = file number
    File number increments for every file
    [configuration.h]
2019-07-23 Rename src/piggy_back_loggers/SD_Mag_LIS3MDL_Prototype/Firmware/Firmware.hex to Current_Designs/Residential_Prototype/Firmware/Firmware.hex
    Reorganizing to make individual datalogger projects easier to find.
2019-07-23 Reorganizing to make it easier to find particular dataloggers
    [configuration.h]
2019-07-23 Schematic of electronics added to Datalogging Shield
2019-08-13 Committed under-development code for the computational prototype
    This code is for the ATmega328p microcontroller
2019-08-14 Added software files for Raspberry Pi and updated README.md. The software files are not yet completed, but they show the planned framework.
2019-08-14 Fixed syntax errors in logger.c
    [logger.c]
2019-08-15 Changed setup.sh to increase default SPI buffer size allocation to accomodate our rather large SPI writes.
2019-08-15 Updated setup.sh to set up the Raspberry Pi for UART Communication
2019-08-15 Added UART Communication module called reportSwap() to Logger module. Used with communication between AVR datalogger and Pi
2019-08-26 Report swapping over UART now semi-functional
    [logger.c, test.py]
2019-08-26 Noted issues with computational prototype software in README.md
2019-08-28 Added RawDataCollector program in Tools folder. Stores raw data from magnetometer.
2019-08-29 Added a python module to read and process data
    [RAW_DATA.CSV]
2019-08-30 Added a function to write processed data to a file, added helpful information in example.py
    [X_Data.csv]
2019-09-09 Fixed occurences of segmentation fault in function loadData() in file logger.c. Updated setup.sh
    [logger.c]
2019-09-10 Fixed firmware bug. AVR SPI pins set as inputs when host computer uses EEPROM.
    [Computational_Firmware.ino, comm.cpp, comm.h]
2019-09-10 Fixed a firmware bug, constant data accidentally overwritten.
    [comm.cpp, storeNewRecord.cpp]
2019-09-10 Fixed firmware bug: datalogger would crash after powering the raspberry pi three times. Issue fixed.
    [powerSleep.cpp]
2019-09-10 Added short delay at the end of reportSwap().
    [logger.c]
2019-09-10 Fixed firmware bug: UART was transmitting at 2x speed
    [comm.cpp]
2019-09-11 Fixed RTC date/time format mismatch.
    [Computational_Firmware.ino, comm.cpp]
2019-09-12 Fixed Firmware Bug (see extended)
    Fixed Firmware Bug: Datalogger would freeze when it turned on the Raspberry Pi computer.
    [Computational_Firmware.ino, storeNewRecord.cpp]
2019-09-12 Fixed RTC date/time bad write bug, fixed bad EEPROM writes
    [Computational_Firmware.ino, comm.cpp, storeNewRecord.cpp]
2019-09-19 Fixed: Segmentation fault after multiple calls to reportSwap(). Added: Separate Logger.initPins() function allows Logger module to be re-used without setting control pins low, signaling a power-off.
    [logger.c, template.py]
2019-10-21 Added SD Card write error checking CURRENTLY UNDER TESTING
    [Firmware.ino, MemoryFree.cpp, powerSleep.cpp, powerSleep.h, state.cpp, state.h]
